ambibayangos/60W-20V-Buck-Converter-in-CCM/README.md

# 60W-20V-Buck-Converter-in-CCM
A 60W 24V synchronous buck converter with digital PID control for output current and output voltage. Output voltage can vary from 100mV to 20V at 100mV increments. While the current can be adjusted from 100mA to 3A at 100mA increments.
