ambibayangos/60W-20V-Buck-Converter-in-CCM/Bode_Plot/OpenLoopGain_Compensated_Type3_FullPower.png

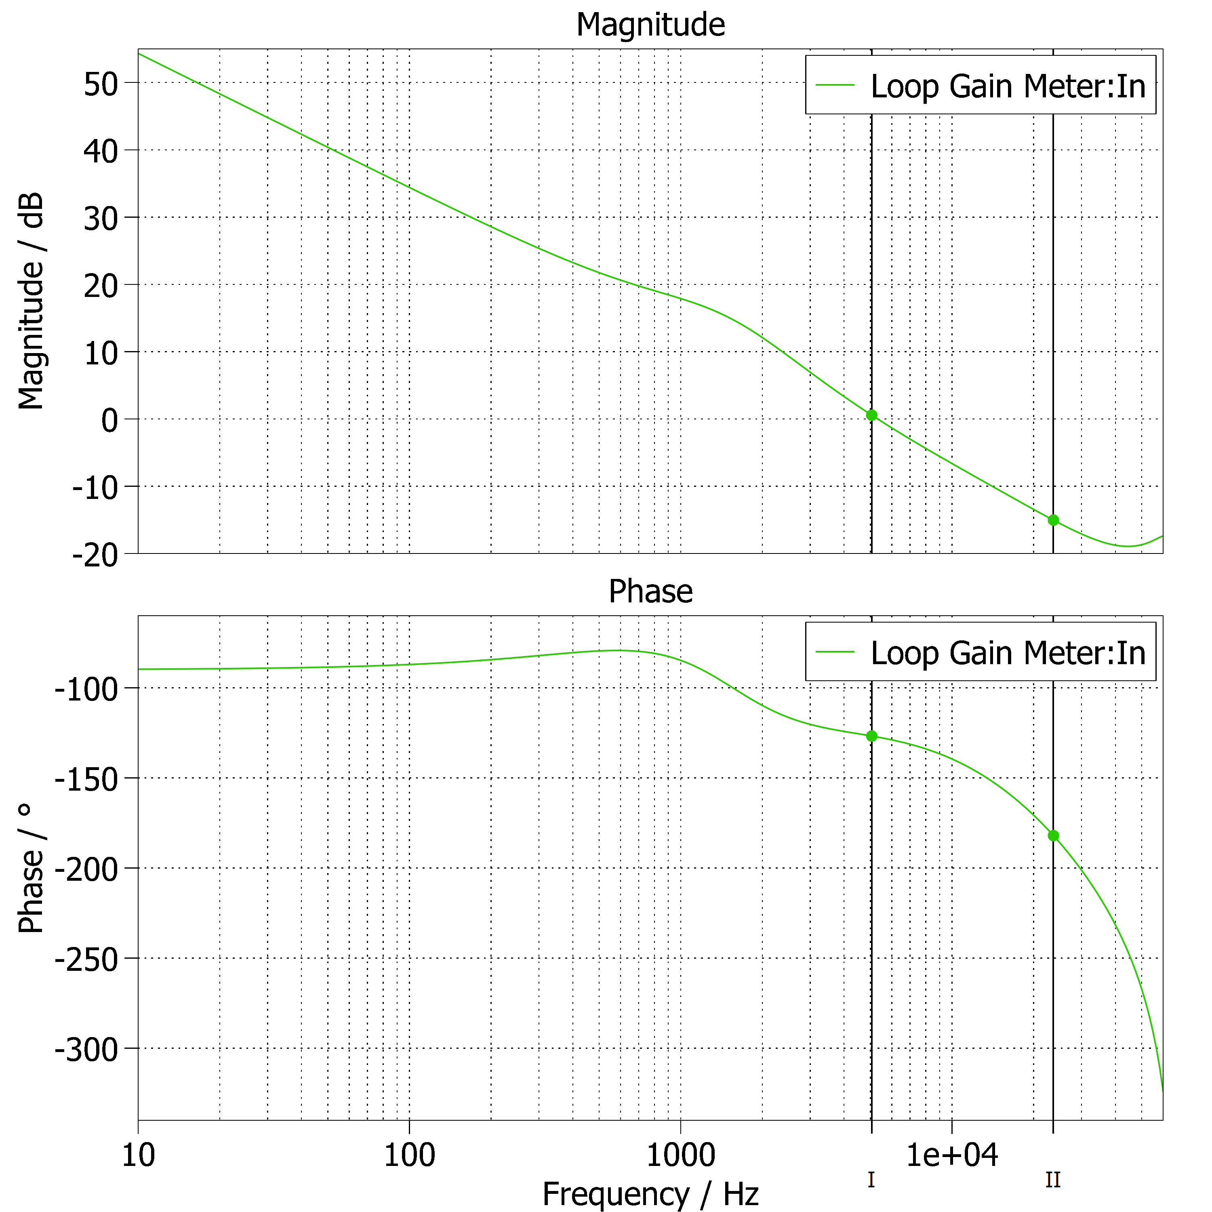
Bode_Plot/OpenLoopGain_Compensated_Type3_FullPower.png
