ambibayangos/60W-20V-Buck-Converter-in-CCM/Calculators/Calculators.xlsx

Sheet: Worst-case inductor ripple
Input parameters |  |  |  |  | NOTE: Worst case ripple current occurs @ 50% duty cycle which is at 12V @ Vin = 24V
L | 150 | uH
F | 70 | kHz |  |  | Worst-Case Ripple | 571.4285714 | mA
Vin | 24 | V
Vo | Duty | L - H | Fs - Hz | Ripple current - mA
0.1 | 0.004166666667 | 0.00015 | 70000 | 9.484126984
0.2 | 0.008333333333 | 0.00015 | 70000 | 18.88888889
0.3 | 0.0125 | 0.00015 | 70000 | 28.21428571
0.4 | 0.01666666667 | 0.00015 | 70000 | 37.46031746
0.5 | 0.02083333333 | 0.00015 | 70000 | 46.62698413
0.6 | 0.025 | 0.00015 | 70000 | 55.71428571
0.7 | 0.02916666667 | 0.00015 | 70000 | 64.72222222
0.8 | 0.03333333333 | 0.00015 | 70000 | 73.65079365
0.9 | 0.0375 | 0.00015 | 70000 | 82.5
1 | 0.04166666667 | 0.00015 | 70000 | 91.26984127
1.1 | 0.04583333333 | 0.00015 | 70000 | 99.96031746
1.2 | 0.05 | 0.00015 | 70000 | 108.5714286
1.3 | 0.05416666667 | 0.00015 | 70000 | 117.1031746
1.4 | 0.05833333333 | 0.00015 | 70000 | 125.5555556
1.5 | 0.0625 | 0.00015 | 70000 | 133.9285714
1.6 | 0.06666666667 | 0.00015 | 70000 | 142.2222222
1.7 | 0.07083333333 | 0.00015 | 70000 | 150.4365079
1.8 | 0.075 | 0.00015 | 70000 | 158.5714286
1.9 | 0.07916666667 | 0.00015 | 70000 | 166.6269841
2 | 0.08333333333 | 0.00015 | 70000 | 174.6031746
2.1 | 0.0875 | 0.00015 | 70000 | 182.5
2.2 | 0.09166666667 | 0.00015 | 70000 | 190.3174603
2.3 | 0.09583333333 | 0.00015 | 70000 | 198.0555556
2.4 | 0.1 | 0.00015 | 70000 | 205.7142857
2.5 | 0.1041666667 | 0.00015 | 70000 | 213.2936508
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
19.5 | 0.8125 | 0.00015 | 70000 | 348.2142857
19.6 | 0.8166666667 | 0.00015 | 70000 | 342.2222222
19.7 | 0.8208333333 | 0.00015 | 70000 | 336.1507937
19.8 | 0.825 | 0.00015 | 70000 | 330
19.9 | 0.8291666667 | 0.00015 | 70000 | 323.7698413
20 | 0.8333333333 | 0.00015 | 70000 | 317.4603175

Sheet: Inductance values @ Frequency
Input parameters
Vin | 24 | V
Vout | 12 | V
Iout max | 3 | A
r | 0.4
Fs - kHz | L - uH
10 | 500
15 | 333.3333333
20 | 250
25 | 200
30 | 166.6666667
35 | 142.8571429
40 | 125
45 | 111.1111111
50 | 100
55 | 90.90909091
60 | 83.33333333
65 | 76.92307692
70 | 71.42857143 | >===> This option is for 560ns minimum on-time with Vout_min = 1V
75 | 66.66666667
80 | 62.5
85 | 58.82352941
90 | 55.55555556
95 | 52.63157895
100 | 50

Sheet: Type 3 Compensator
Inputs
Gain needed at fc | 4 | dB
fcrossover | 7 | kHz
fz1 , fz2 | 1.4 | kHz
Vout | 20 | V
Vref | 2.5 | V
R1 | 100 | kOhm
Gain needed at fc | 1.584893192 | linear units
fcrossover | 7000 | Hz
fz1 , fz2 | 1400 | Hz
R1 | 100000 | Ohm
fp1,fp2 | 35000 | Hz
fp1,fp2 | 35 | KHz
Outputs
Rlower | 14285.71429 | Ohm
R2 | 31697.86385 | Ohm
R3 | 4166.666667 | Ohm
C1 | 3.586427866e-09 | H
C2 | 1.494344944e-10 | H
C3 | 1.091348181e-09 | H
Rlower | 14.28571429 | kOhm
R2 | 31.69786385 | KOhm
R3 | 4.166666667 | KOhm
C1 | 3.586427866 | nH
C2 | 0.1494344944 | nH
C3 | 1.091348181 | nH
