ambibayangos/60W-20V-Buck-Converter-in-CCM/Ltspice simulation models/Evaluate_Mosfet_Switching_Time/Draft2.asc

C1: cap; 16.5m
R1: res; 1
S1: sw; MySwitch
V1: voltage; PULSE(0 1 10m 400n 400n 1 1 1)
Named nets: vcap, 0
.IC V(vcap) = 70
.tran 20m
.model MySwitch SW(Ron=.1 Roff=1Meg)
