ambibayangos/60W-20V-Buck-Converter-in-CCM/Ltspice simulation models/Evaluate_Mosfet_Switching_Time/Mosfet_Switch_Time_Eval.asc

R1: res; 10k
R2: res; 10
U1: irfb_s_sl3806pbf
V1: voltage; 24
V2: voltage; PULSE(0 12 0 20n 20n 5e-5 1e-4)
Named nets: 0
.tran 1m
