ambibayangos/60W-20V-Buck-Converter-in-CCM/Ltspice simulation models/buck_simplified.asc

C1: cap; 470µ
C2: cap; 100µ
D1: schottky; MBR745
L1: ind; 150µ
L2: ind; 100µ
M1: nmos; BSC060N10NS3
R1: res; 6.67
V1: voltage; 24
V2: voltage; PULSE(0 12 0 100n 100n {D/freq} {1/freq})
Named nets: 0
.param freq=100k D=0.83
.tran 0 {100m + 5/freq} 100m 100n
