ambibayangos/60W-20V-Buck-Converter-in-CCM/Ltspice simulation models/XTAL simulation/Pierce_CMOS.asc

C1: xtal; 0.003p; Rser=50k Lser=7863 Cpar=1.35p
C2: cap; 25p
C3: cap; 25p
M1: pmos4; MHCPEN; W=220U L=2.4U AD=1000P PD=30U
M2: nmos4; MHCNEN; W=100U L=2.4U AD=500P PD=30U
R1: res; 10Meg
R2: res; 300k
V1: voltage; 1.8V
Named nets: 0, in, out, D, VDD
.tran 0 1 0 1u uic
.opt reltol=10u
.Model MHCNEN NMOS (LEVEL=3 RS=40 RD=40
+KP=45.3E-6 VTO=0.72 TOX=51.5E-9 nfs=1.E+11
+NSUB=2.8E15 GAMMA=0.94 PHI=0.65 VMAX=150E3 RS=13.3 RD=13.3
+XJ=0.11E-6 LD=0.52E-6 THETA=0.054 ETA=0.025 KAPPA=0.0)
.Model MHCPEN PMOS (LEVEL=3 RS=80 RD=80
+KP=22.1E-6 VTO=-0.71 TOX=51.5E-9 NSUB=3.3E16 nfs=7E+11
+GAMMA=0.92 PHI=0.65 VMAX=970E3
+XJ=0.63E-6 LD=0.23E-6 THETA=0.108 ETA=0.322 )
MP1 out 4 vcc vcc MHCPEN W=220U L=2.4U AD=1000P PD=30U
MN1 out 4 gnd gnd MHCNEN W=100U L=2.4U AD=500P PD=30U
