ambibayangos/60W-20V-Buck-Converter-in-CCM/Ltspice simulation models/XTAL simulation/Pierce_OPAMP.asc

C1: cap; 0.003p
C2: cap; 1.35p
C3: cap; 25p
C4: cap; 25p
C5: cap; 220n; Rser=2
C6: cap; 100n
L1: ind; 7863
R1: res; 50k
R2: res; 300k
R3: res; 1k
R4: res; 50k
R5: res; 1Meg
R6: res; 3.3k
R7: res; 3.3k
U3: RH1814
U4: RH1814
V2: voltage; 3.3
Named nets: 0, Vcc
.tran 0 3 2
