ambibayangos/60W-20V-Buck-Converter-in-CCM/(list of files, drawings)

Other design files:
PCB/60W20V_BuckConverter/60W20V_BuckConverter.PrjPcb
PCB/60W20V_BuckConverter/Buck_60W20V_Control_Section.SchDoc
PCB/60W20V_BuckConverter/Buck_60W20V_MCU_AuxPSU.SchDoc
PCB/60W20V_BuckConverter/Buck_60W20V_Overview.SchDoc
PCB/60W20V_BuckConverter/Buck_60W20V_Power_Section.SchDoc
PCB/60W20V_BuckConverter/Feedback_Controller_Buck.SchDoc
PCB/60W20V_BuckConverter/Main_Buck.SchDoc
PCB/60W20V_BuckConverter/MCU_buck.SchDoc
PCB/60W20V_BuckConverter/PCB1.PcbDoc
PCB/60W20V_BuckConverter/Top_View.SchDoc
