ambibayangos/60W-20V-Buck-Converter-in-CCM/Resources/Issues_Resources/06_ Output cap setup.PNG

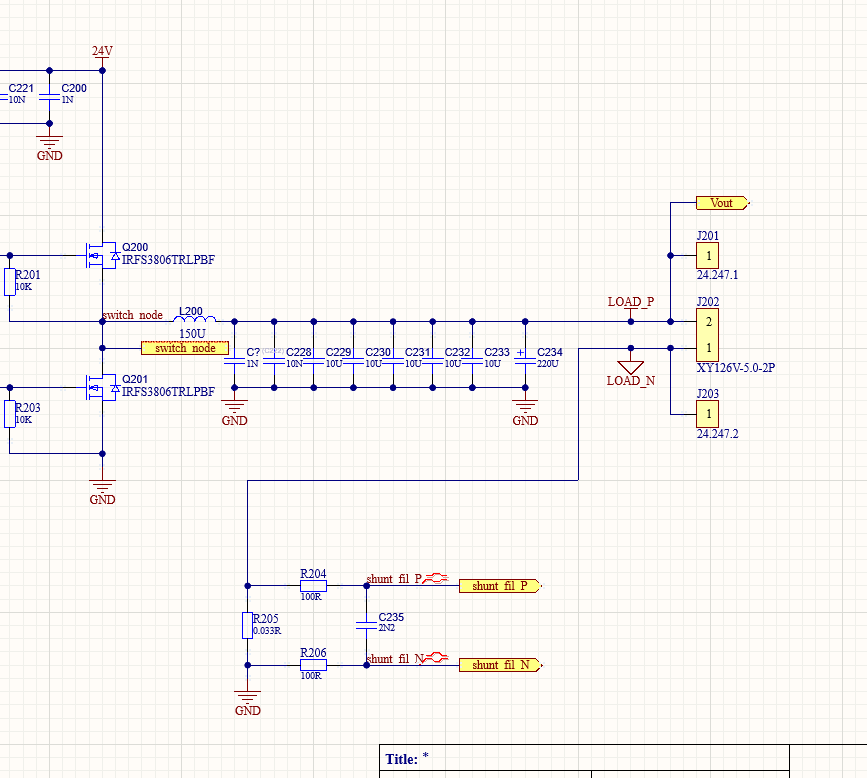
Resources/Issues_Resources/06_ Output cap setup.PNG
