ambibayangos/60W-20V-Buck-Converter-in-CCM/Resources/Issues_Resources/01_Ceramic Cap Cin Computation.PNG

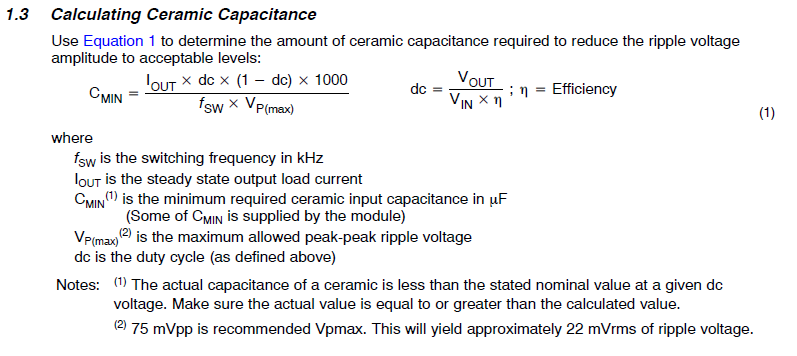
Resources/Issues_Resources/01_Ceramic Cap Cin Computation.PNG
