ambibayangos/60W-20V-Buck-Converter-in-CCM/Resources/Issues_Resources/02_Cemeramic Cap RMS LTspice simulation.PNG

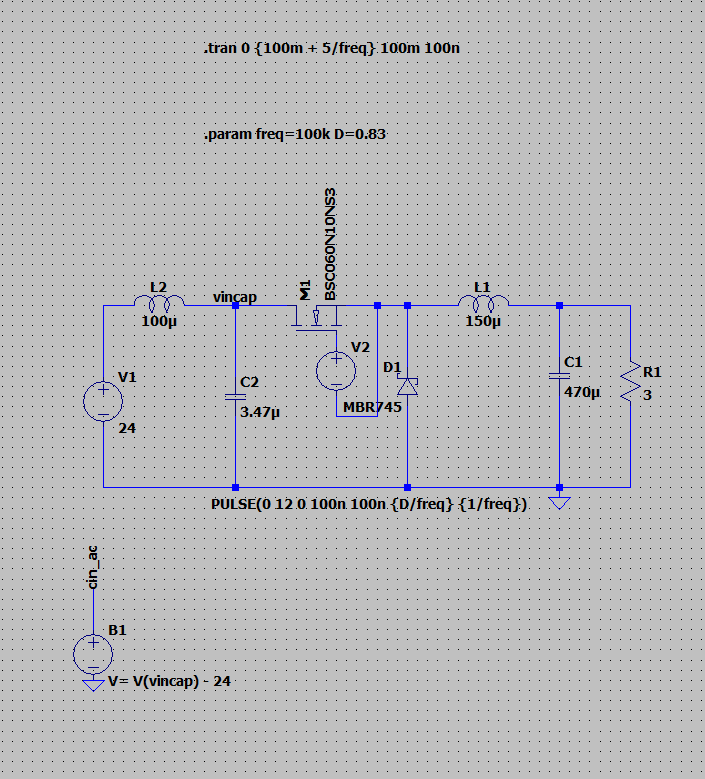
Resources/Issues_Resources/02_Cemeramic Cap RMS LTspice simulation.PNG
