ambibayangos/60W-20V-Buck-Converter-in-CCM/Resources/Issues_Resources/03_Ceramic cap DC bias from taiyo yuden.PNG

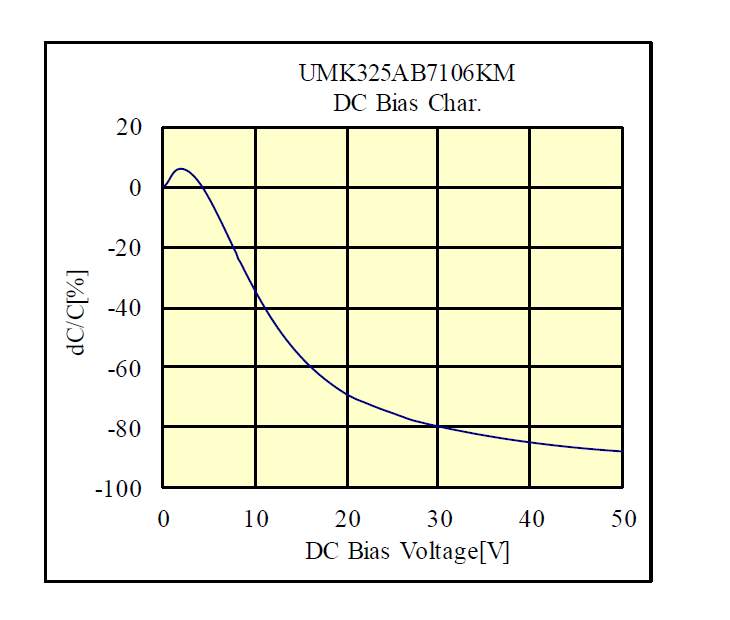
Resources/Issues_Resources/03_Ceramic cap DC bias from taiyo yuden.PNG
