ambibayangos/60W-20V-Buck-Converter-in-CCM/Resources/Issues_Resources/04_Ripple current.PNG

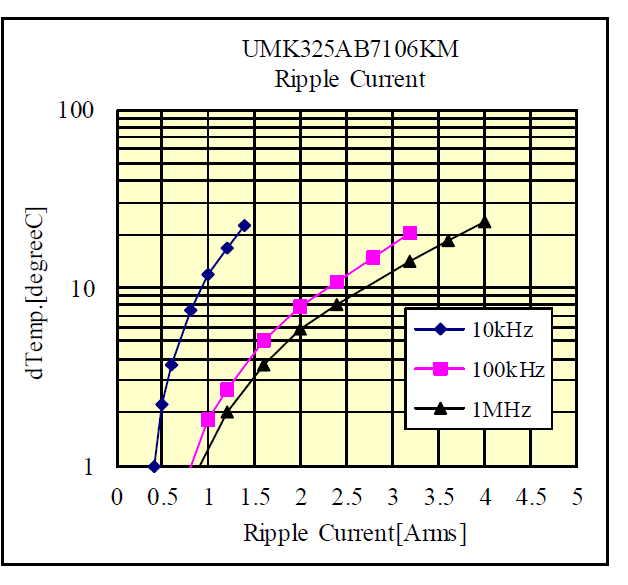
Resources/Issues_Resources/04_Ripple current.PNG
