ambibayangos/60W-20V-Buck-Converter-in-CCM/(threads)

Thread 1 (2024-02-18):

Input capacitor computation

ambibayangos, 2024-02-18:
This issue documents the computation for the Cin.

Thread 2 (2024-02-19):

Output capacitor selection for voltage ripple

ambibayangos, 2024-02-19:
### How to esimate Vout ripple analytically?
Expression below from SLVA630A (TI app note) shows how to approximate the output voltage ripple.
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
Where:
Ip2p - inductor curren ripple @ worst case in A
C - output capacitance in F
Fs - switching freq in Hz
R - ESR of output capacitor in ohm
D - Duty cycle
Vout,p2p - output voltage ripple.
