ambibayangos/60W-20V-Buck-Converter-in-CCM/(commit log)

2023-02-06 Added a few resource documents - (about TTL and CMOS and MOSFET self turn-on)
    Added a few resource documents - (about TTL and CMOS and MOSFET self turn-on)
2023-06-24 Add new resource documents
    [60W20V_BuckConverter.PrjPcb]
2023-06-25 Create digital PID simulation model
    Also upload NUCLEO-L467RG pin mapping.
2023-06-25 Create adjustable buck model with adjustable Vset
    Simulated buck @10kHz Fs with digital PID controller sampling at 2.4Mhz. The simulation indicates that
    its hard to get Vo of 1.2V and below because the digital PID approach seems to oscillate the Vout a lot.
    The failure to get even 1.2V Vout to regulate with digital PID prompted me to look at different way to
    have adjustable Vset and Iset. One way I thought of was to add offset into the Vfb and Ifb. The model I'm uploading explored adding offset to Vfb to achieve a variable Vset. Overall, this approach seems to
    do better than the digital PID approach as it can regulate down to 1V without anyproblem. However, it can't seem to regulate down b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
2023-06-26 Create buck model with adjustable Iset and Vset
2023-07-14 Compensate system at fullpower with Type3 compensator
    ------ Simulating compensation notes to prevent headache later -----------
    Note to make the impulse response work:
    The #of iterations can be increased to the
    point when we know the system is at steady
    state.
    Also, Adding initial voltage at Cout seemed
    to generate results that somewhat make sense.
    Note to remove steady state error due to slope compensation:
    If the compesating ramp ends at "X", e.g X = 0.5, then the max
    saturation limit for the compensation block output needs to be
    set to 1+X, e.g., if X = 0.5, then max saturation limit need to be
    1.5 (1+0.5).
    ---------------------------------------------------------------------------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
    [Calculators.xlsx]
2023-09-25 Upload simulation files used for compensation & some resources
    Also upload a LTspice simulation used to evaluate the switching time
    of the MOSFET. This was investigated because I wanted to know if the
    MCU would be fast enough to sample Iout and Vout even when the duty
    cycle is very very low. Conclusion is... that the MCU is not fast enough so
    I am forced to do the compensation in analogue instead of digital.
    Also upload some new resources. These are just some STM32 pinout
    and LCD related documents. Also upload document related to good
    grounding prentices for mixed signal PCBs.
2024-02-08 Add resources
    Added documents that details how to implement a standalone MCU (without dev board).
    [Resource_Directory.xlsx]
2024-02-11 Add the nicer schematics
    Also add new resources
    [00_Resource_Directory.xlsx, 60W20V_BuckConverter.PrjPcb, Buck_60W20V_Control_Section.SchDoc, Buck_60W20V_MCU_AuxPSU.SchDoc, Buck_60W20V_Overview.SchDoc, Buck_60W20V_Power_Section.SchDoc]
2024-02-11 Remove test components
    [Buck_60W20V_Overview.SchDoc, Buck_60W20V_Power_Section.SchDoc]
2024-02-11 Schematics work with new lib & buzzer circuit
    - Need to add USB-C, USB-B mini and SW debug line.
    - Also need to add LCD female headers.
    Redesigned how the buzzer circuit is driven.
    Before it was driven directly from the MCU ports GPIO. But now I made it being driven by 5V, but MCU can turn it on via a NPN BJT.
    [60W20V_BuckConverter.PrjPcb, Buck_60W20V_Control_Section.SchDoc, Buck_60W20V_MCU_AuxPSU.SchDoc, Buck_60W20V_Power_Section.SchDoc, Feedback_Controller_Buck.SchDoc, MCU_buck.SchDoc, Main_Buck.SchDoc]
2024-02-12 Add USB, SW debug and LCD connectors
    [MCU_buck.SchDoc]
2024-02-13 Add power supply schematics
    Added 12V LDO to replace the 12V buck
    since the 12V just need to supply the gate driver.
    Need to add LED indication next.
    [60W20V_BuckConverter.PrjPcb, Buck_60W20V_MCU_AuxPSU.SchDoc, Buck_60W20V_Overview.SchDoc, Feedback_Controller_Buck.SchDoc, MCU_buck.SchDoc, Main_Buck.SchDoc, Top_View.SchDoc]
2024-02-17 Add RGB LED & Banana jack for output
    Considering adding a molex connector on the input.
    [Feedback_Controller_Buck.SchDoc, MCU_buck.SchDoc, Main_Buck.SchDoc]
2024-02-18 Replace headers with 16X2 LCD module
    Also considering redesigning the Cin because the Cin value just seems too high. Read an app notr and was convinced my Cin ceramic capacitors are too high.
    [60W20V_BuckConverter.PrjPcb, Feedback_Controller_Buck.SchDoc, MCU_buck.SchDoc, Main_Buck.SchDoc, Top_View.SchDoc]
2024-02-18 Redesign the ceramic input cap value
    See Issue #1 for details.
    [Main_Buck.SchDoc]
2024-02-18 Update resource directory
    [00_Resource_Directory.xlsx, PCB1.PcbDoc]
2024-02-19 Reduce the outptu ceramic caps
    See Issue #2 on github for details.
    [Main_Buck.SchDoc]
2024-02-23 Add barrel jack in input & molex connector
    [Main_Buck.SchDoc]
2024-02-24 Finish initial component placement
    Need to route tracks next.
    [00_Resource_Directory.xlsx, Feedback_Controller_Buck.SchDoc, MCU_buck.SchDoc, Main_Buck.SchDoc, Top_View.SchDoc]
2024-02-25 Finish initial routing
    Layout is pretty much done.
    Next is to tidy silk screen.
    Add PCB name.
    Add a few test points.
    [Feedback_Controller_Buck.SchDoc, MCU_buck.SchDoc, Main_Buck.SchDoc, Top_View.SchDoc]
2024-02-25 Tidy the silkscreen
    Increased PCB clearance to 0.2mm.
    Need to add board name next.
2024-02-25 Add output labels and board name
2024-02-25 Fix SW node not added
    [60W20V_BuckConverter.PrjPcb, Feedback_Controller_Buck.SchDoc, MCU_buck.SchDoc, Main_Buck.SchDoc, Top_View.SchDoc]
2024-02-25 Add Drafts man docs
    Add manufacturing files
    [60W20V_BuckConverter.PrjPcb, Bill of Materials-60W20V_BuckConverter.xlsx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]
2024-02-28 Redo power stitching & add logo
2024-03-07 Add fabrication files
    Had issue with BOM as RES and CAP are all group because they use generic symbol. Solved it by using "group by" in the Job file BOM section. See this link for details:
    https://www.altium.com/documentation/altium-designer/bom-configuration-report-manager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
    [60W20V_BuckConverter.PrjPcb, Bill of Materials-60W20V_BuckConverter.xlsx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]
